OptogeneticsandNeuralEngineeringCore/DynamicClamp/README.md

# DynamicClamp
Expansion of the "A Dynamic Clamp on Every Rig" by Niraj S. Desai
