OptogeneticsandNeuralEngineeringCore/DynamicClamp/DC Information Flow.pdf

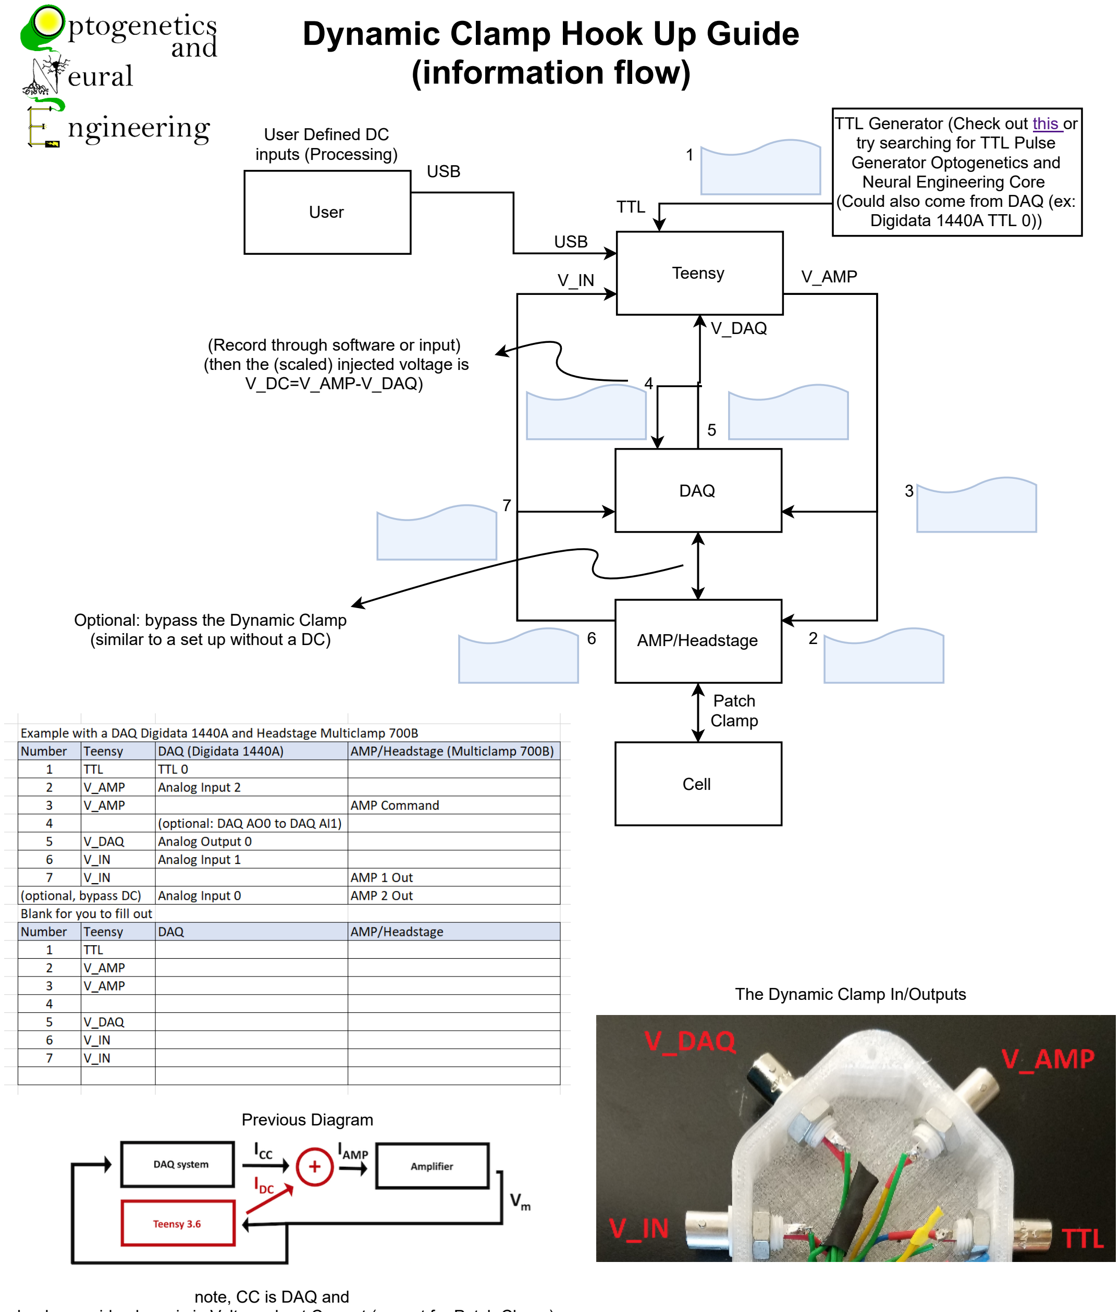
[picture p1: figure]
Teensy; User; DAQ; AMP/Headstage; Cell; V_AMP; Patch Clamp; (Record through software or input) (then the (scaled) injected voltage is V_DC=V_AMP-V_DAQ); User Defined DC inputs (Processing); TTL Generator (Check out this or try searching for TTL Pulse Generator Optogenetics and Neural Engineering Core (Could also come from DAQ (ex: Digidata 1440A TTL 0)); TTL; The Dynamic Clamp In/Outputs; note, CC is DAQ and; Dynamic Clamp Hook Up Guide (information flow); Previous Diagram; USB; V_DAQ; Optional: bypass the Dynamic Clamp (similar to a set up without a DC)

the hook up guide above is in Volts and not Current (except for Patch Clamp)

Reference:
Niraj S. Desai, Richard Gray, and Daniel Johnston.
A dynamic clamp on every rig. eNeuro (DOI:10.1523/ENEURO.0250-17.2017 (https://www.draw.io/Niraj%20S.%20Desai,%20Richard%20Gray,%20and%20Daniel%20Johnston.%20A%20dynamic%20clamp%20on%20every%20rig.%20eNeuro%20(DOI:10.1523/ENEURO.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)
