OptogeneticsandNeuralEngineeringCore/DynamicClamp/DynamicClampBottomCompact.stl

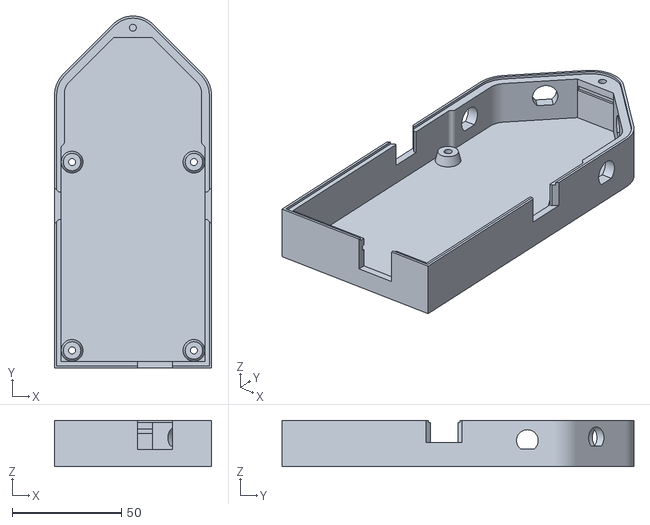
[picture p2: CAD file, 2017-12-21]
DynamicClampBottomCompact.stl
72.0 x 161.4 x 21.3
