OptogeneticsandNeuralEngineeringCore/DynamicClamp/DynamicClampTop.stl

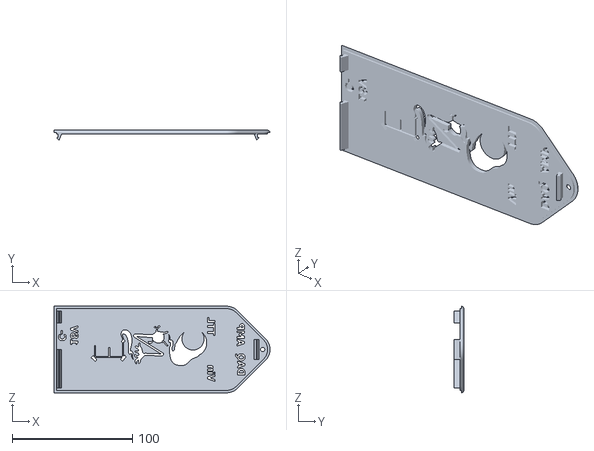
[picture p3: CAD file, 2017-12-20]
DynamicClampTop.stl
179.4 x 8.00 x 72.0
