OptogeneticsandNeuralEngineeringCore/DynamicClamp/DynamicClampTopMegaCompact.stl

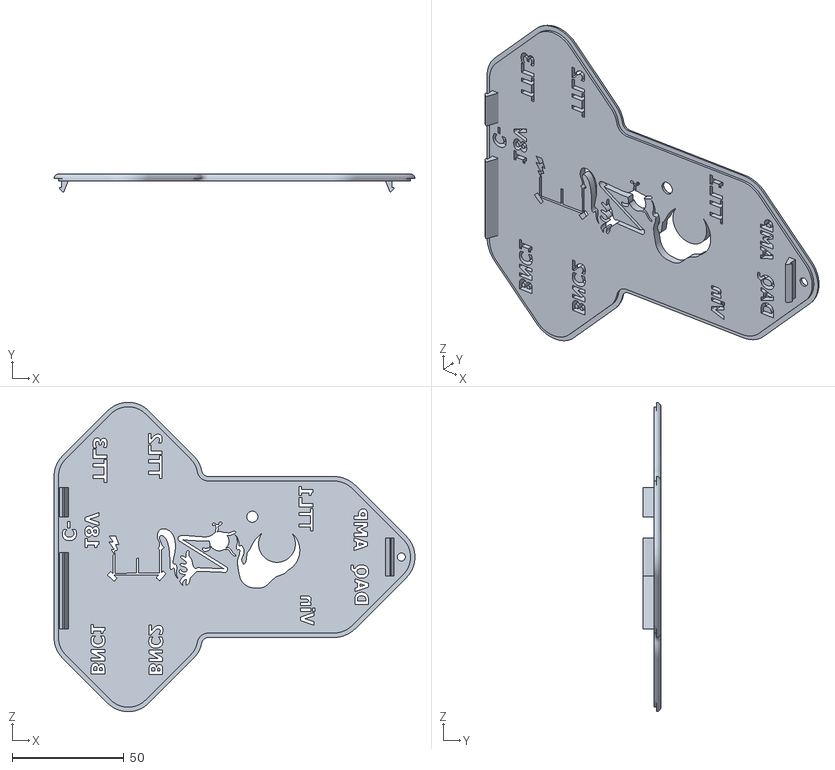
[picture p4: CAD file, 2017-12-20]
DynamicClampTopMegaCompact.stl
161.4 x 8.00 x 138.3
