OptogeneticsandNeuralEngineeringCore/DynamicClamp/DynamicClampTopCompact.stl

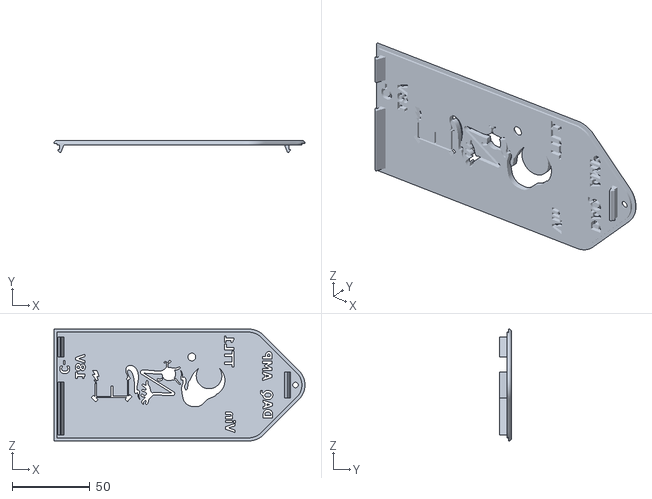
[picture p5: CAD file, 2017-12-20]
DynamicClampTopCompact.stl
161.4 x 8.00 x 72.0
