OptogeneticsandNeuralEngineeringCore/DynamicClamp/DynamicClampBottom.stl

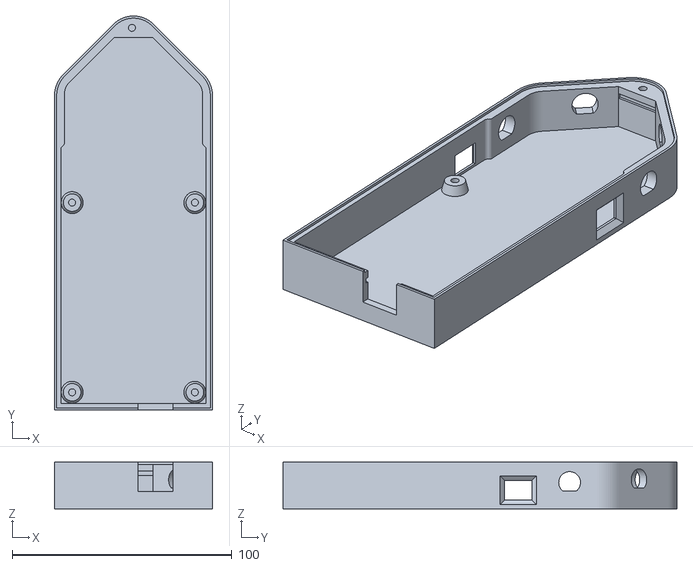
[picture p6: CAD file, 2017-12-20]
DynamicClampBottom.stl
72.0 x 179.4 x 21.3
