OptogeneticsandNeuralEngineeringCore/DynamicClamp/DynamicClampMegaTop.stl

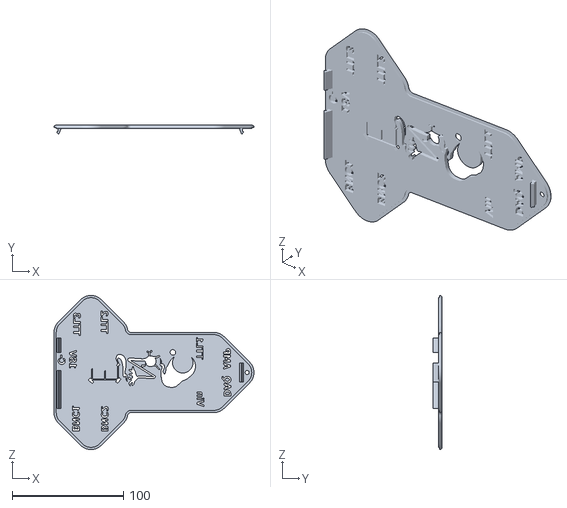
[picture p7: CAD file, 2017-12-20]
DynamicClampMegaTop.stl
179.4 x 8.00 x 138.3
