OptogeneticsandNeuralEngineeringCore/DynamicClamp/DynamicClampBottomMegaCompact.stl

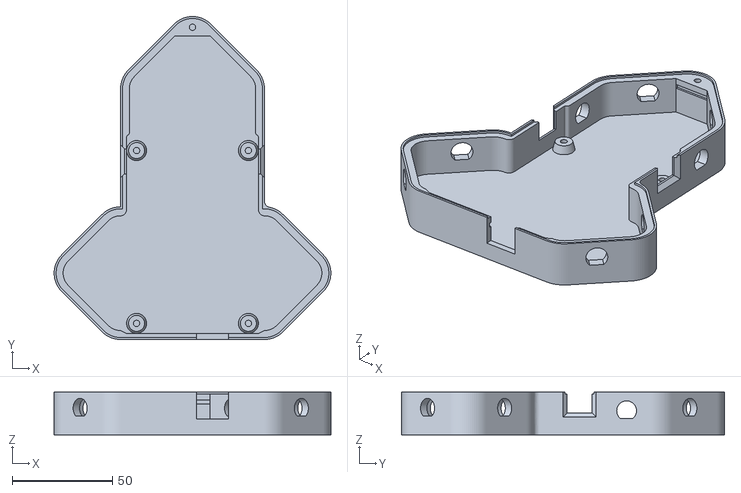
[picture p8: CAD file, 2017-12-20]
DynamicClampBottomMegaCompact.stl
138.3 x 161.4 x 21.3
