OptogeneticsandNeuralEngineeringCore/DynamicClamp/(list of files, cad)

Other CAD files:
DynamicClampBottom.ipt
DynamicClampBottomCompact.ipt
DynamicClampBottomMegaCompact.ipt
DynamicClampMegaTop.ipt
DynamicClampTop.ipt
DynamicClampTopCompact.ipt
DynamicClampTopMegaCompact.ipt
