OptogeneticsandNeuralEngineeringCore/DynamicClamp/(list of files, drawings)

Other design files:
Compact.fzz
CompactRobust.fzz
