OptogeneticsandNeuralEngineeringCore/DynamicClamp/(commit log)

2017-12-20 Uploada da filez
    [Calibration Of Dynamic Clamp UnitNumberXyZ.xlsx, Compact.fzz, CompactRobust.fzz, DynamicClampBottom.ipt, DynamicClampBottom.stl, DynamicClampBottomMegaCompact.ipt, DynamicClampBottomMegaCompact.stl, DynamicClampMegaTop.ipt]
2017-12-21 Forgotta deez filez
    [DynamicClampBottomCompact.ipt, DynamicClampBottomCompact.stl]
